SantangeloEzequiel/tdse-tf_3-06/images/Esquemático.pdf

256B

## DIR = 0x50

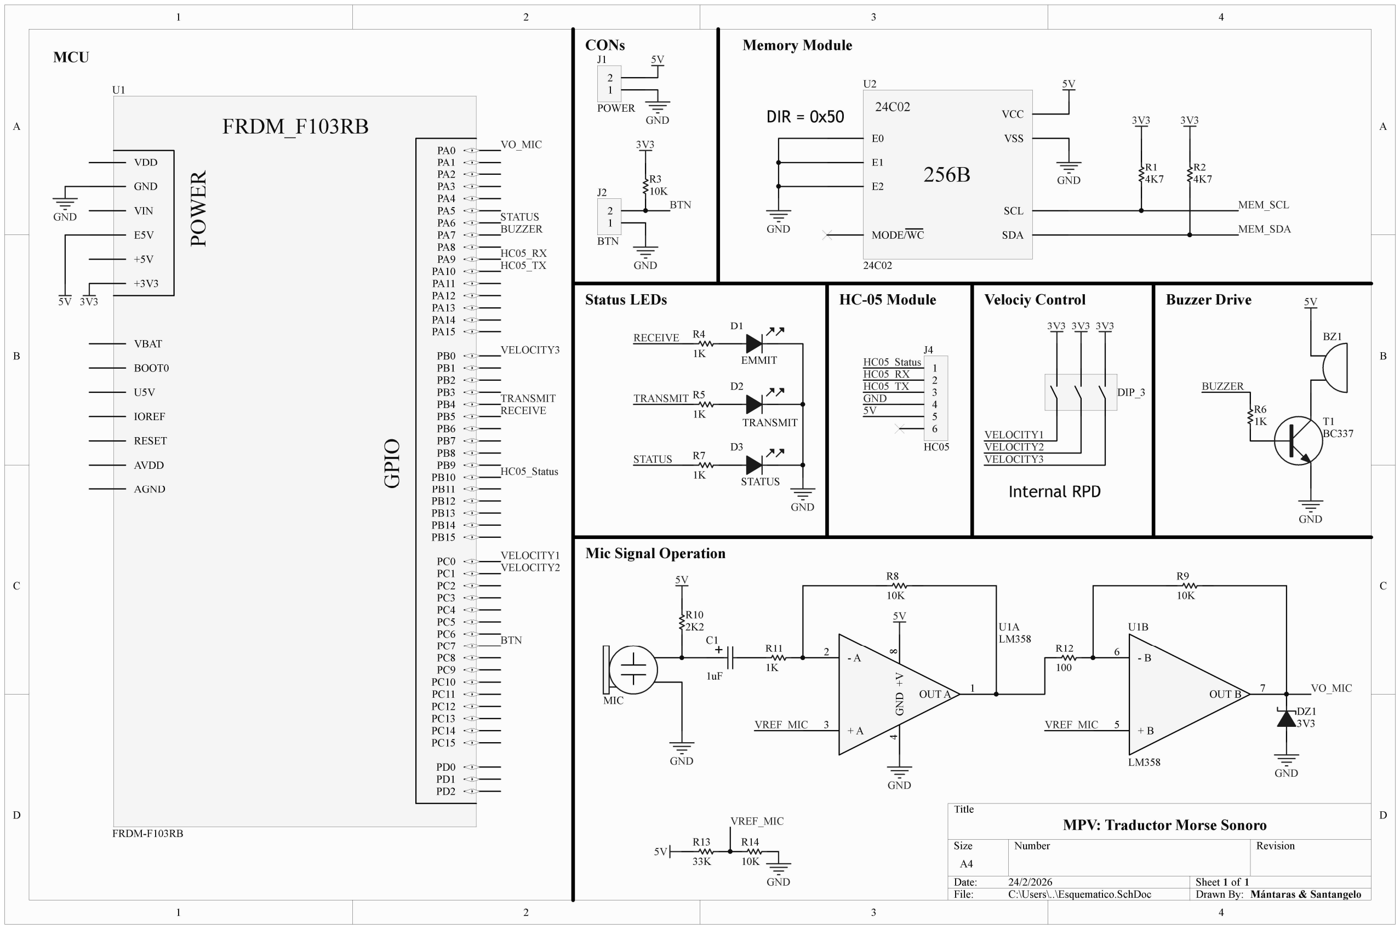
[picture p2: page 1]

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
Title

Size | Number | Revision
A4
Date: | 24/2/2026 | Sheet of
File: | C:\Users\..\Esquematico.SchDoc | Drawn By:

+ A 3

- A 2

OUT A 1 ⁺V

## 8 GND

4

U1A
LM358

24C02

E0

E1

E2

MODE/WC

VCC

VSS

SCL

SDA

U2

24C02

+ B 5

- B 6

OUT B 7

U1B

LM358

MIC

5V

GND

R1
4K7

R2
4K7

3V3 3V3

MEM_SCL

GND | MEM_SDA

T1
BC337

5V

GND

R6
1K

BUZZER

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
HC05 +

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
VO_MIC

VREF_MIC | VREF_MIC

5V

5V

R13
33K

R14
10K
GND

VREF_MIC

D2

TRANSMIT

D1

EMMIT

D3

STATUS

GND

R4
1K

R5
1K

R7
1K

RECEIVE

TRANSMIT

STATUS

HC05_Status
HC05_RX
HC05_TX
GND
5V

1

2

J1

POWER

GND

5V 3V3

DIP_3

3V3 3V3 3V3

VELOCITY1
VELOCITY2
VELOCITY3

# FRDM_F103RB

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
PA10
PA11
PA12
PA13
PA14
PA15

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
PB10
PB11
PB12
PB13
PB14
PB15

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
PC10
PC11
PC12
PC13
PC14
PC15

PA6

PC6

PB6 GPIO

PD0
PD1
PD2

PA0
VDD

GND

+3V3

+5V

VBAT

BOOT0

E5V

IOREF

RESET

VIN

AVDD

U5V

# AGND POWER

U1

FRDM-F103RB

GND

5V

VELOCITY1
VELOCITY2

VELOCITY3

HC05_Status

HC05_TX

HC05_RX

TRANSMIT
RECEIVE

STATUS

VO_MIC

## Internal RPD

BUZZER | 1
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
## MCU

CONs | Memory Module
Status LEDs | HC-05 Module | Velociy Control | Buzzer Drive

## Mic Signal Operation

## MPV: Traductor Morse Sonoro

1 1
Mántaras & Santangelo

BZ1
