SantangeloEzequiel/tdse-tf_3-06/images/Morse_Code.png

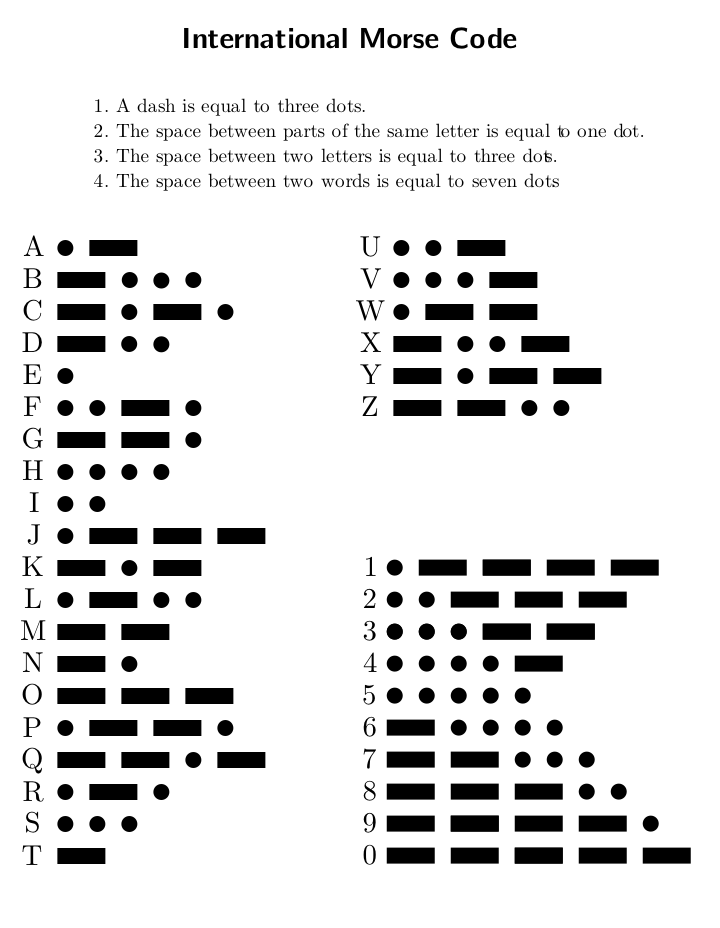
images/Morse_Code.png
