SantangeloEzequiel/tdse-tf_3-06/CubeIDEProjects/Grabador de Memoria/Core/Src/main.c

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
/* Includes ------------------------------------------------------------------*/
#include "main.h"
#include "i2c.h"
#include "usart.h"
#include "gpio.h"

/* USER CODE BEGIN Includes */
#include "morse.h"
#include <stdint.h>
/* USER CODE END Includes */

/* USER CODE BEGIN PD */
#define READ
#define WRITE
/* USER CODE END PD */


void SystemClock_Config(void);
/**
  * @brief  The application entry point.
  * @retval int
  */
int main(void)
{

  /* MCU Configuration--------------------------------------------------------*/

  /* Reset of all peripherals, Initializes the Flash interface and the Systick. */
  HAL_Init();

  /* Configure the system clock */
  SystemClock_Config();

  /* Initialize all configured peripherals */
  MX_GPIO_Init();
  MX_I2C1_Init();
  MX_USART2_UART_Init();
  /* Infinite loop */
  /* USER CODE BEGIN WHILE */
  while (1)
  {
    /* USER CODE END WHILE */

    /* USER CODE BEGIN 3 */
	#ifdef WRITE
	  for (uint8_t i = 0 ; i < MORSE_TOTAL_SPACE_BYTES/2 ; i+=2 ){
		  EEPROM_WriteByte( i, error.morse);
		  EEPROM_WriteByte( i+1, error.symbol);
	  };

	  for (uint8_t i = 0 ; i < MORSE_TOTAL_CHARACTERS ; i++ ){
		EEPROM_WriteByte( morse_table[i].index*2, morse_table[i].morse);
		EEPROM_WriteByte( morse_table[i].index*2 + 1, morse_table[i].symbol);
	  };
	  for (uint8_t i = 0 ; i < MORSE_TOTAL_CHARACTERS ; i++ ){
		EEPROM_WriteByte( morse_table_alphabet[i].index*2 + MORSE_TOTAL_SPACE_BYTES + 2, morse_table_alphabet[i].morse);
		EEPROM_WriteByte( morse_table_alphabet[i].index*2 + 1 + MORSE_TOTAL_SPACE_BYTES + 2, morse_table_alphabet[i].symbol);
	  };

	#endif
	#ifdef READ
	  uint8_t caracter , morse;
	  morse = EEPROM_ReadByte(0);
	  caracter = EEPROM_ReadByte(1);

	  morse = EEPROM_ReadByte(2);
	  caracter = EEPROM_ReadByte(3);

	  morse = EEPROM_ReadByte(4);
	  caracter = EEPROM_ReadByte(5);

	#endif
	  break;
  }
  /* USER CODE END 3 */
}

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
