SantangeloEzequiel/tdse-tf_3-06/CubeIDEProjects/Traductor Morse Sonoro/Traductor Morse Sonoro.ioc

Mcu.UserName=STM32F103RBTx
PA0-WKUP.GPIO_Label=MIC
PA0-WKUP.Signal=ADCx_IN0
PA1.Signal=S_TIM2_CH2
PA10.GPIO_Label=UART1_RX
PA10.Signal=USART1_RX
PA13.GPIO_Label=TMS
PA13.Signal=SYS_JTMS-SWDIO
PA14.GPIO_Label=TCK
PA14.Signal=SYS_JTCK-SWCLK
PA2.GPIO_Label=UART2_TX2
PA2.Signal=USART2_TX
PA3.GPIO_Label=UART2_RX
PA3.Signal=USART2_RX
PA6.GPIO_Label=LED_ERROR
PA6.Signal=GPIO_Output
PA7.GPIO_Label=BUZZER
PA7.Signal=GPIO_Output
PA9.GPIO_Label=UART1_TX
PA9.Signal=USART1_TX
PB0.GPIO_Label=VELOCITY3
PB0.Signal=GPIO_Input
PB10.GPIO_Label=UART1_STATUS
PB10.Signal=GPIO_Input
PB3.GPIO_Label=SWO
PB3.Signal=SYS_JTDO-TRACESWO
PB4.GPIO_Label=LED_TRANSMIT
PB4.Signal=GPIO_Output
PB5.GPIO_Label=LED_RECEIVE
PB5.Signal=GPIO_Output
PB6.Signal=I2C1_SCL
PB7.Signal=I2C1_SDA
PC0.GPIO_Label=VELOCITY1
PC0.Signal=GPIO_Input
PC1.GPIO_Label=VELOCITY2
PC1.Signal=GPIO_Input
PC13-TAMPER-RTC.GPIO_Label=B1 [Blue PushButton]
PC13-TAMPER-RTC.Signal=GPXTI13
PC14-OSC32_IN.Signal=RCC_OSC32_IN
PC15-OSC32_OUT.Signal=RCC_OSC32_OUT
PC7.GPIO_Label=BTN_INPUT
PC7.Signal=GPIO_Input
PD0-OSC_IN.Signal=RCC_OSC_IN
PD1-OSC_OUT.Signal=RCC_OSC_OUT
