SantangeloEzequiel/tdse-tf_3-06/CubeIDEProjects/Traductor Morse Sonoro/app/inc/task_sensor.h

#ifndef INC_TASK_SENSOR_H_
#define INC_TASK_SENSOR_H_

/********************** CPP guard ********************************************/
#ifdef __cplusplus
extern "C" {
#endif

/********************** inclusions *******************************************/

/********************** macros ***********************************************/

/********************** typedef **********************************************/

/********************** external data declaration ****************************/
extern uint32_t g_task_sensor_cnt;
extern volatile uint32_t g_task_sensor_tick_cnt;

/********************** external functions declaration ***********************/
extern void task_sensor_init(void *parameters);
extern void task_sensor_update(void *parameters);

/********************** End of CPP guard *************************************/
#ifdef __cplusplus
}
#endif

#endif /* TASK_INC_TASK_SENSOR_H_ */

/********************** end of file ******************************************/
