SantangeloEzequiel/tdse-tf_3-06/CubeIDEProjects/Traductor Morse Sonoro/app/src/task_GPIO_output.c

/********************** inclusions *******************************************/
/* Project includes */
#include "main.h"

/* Demo includes */
#include "logger.h"
#include "dwt.h"

/* Application & Tasks includes */
#include "board.h"
#include "app.h"
#include "task_GPIO_output_attribute.h"
#include "task_GPIO_output_interface.h"

/********************** macros and definitions *******************************/
#define G_TASK_ACT_CNT_INIT			0ul
#define G_TASK_ACT_TICK_CNT_INI		0ul

#define DEL_GPIO_XX_PUL				100ul
#define DEL_GPIO_XX_BLI				500ul
#define DEL_GPIO_XX_MIN				0ul

/********************** internal data declaration ****************************/
const task_GPIO_output_cfg_t task_GPIO_output_cfg_list[] = {
	{ID_LED_RECEIVE,  LED_RECEIVE_PORT,  LED_RECEIVE_PIN, LED_RECEIVE_ON,  LED_RECEIVE_OFF,
	 DEL_GPIO_XX_BLI, DEL_GPIO_XX_PUL},
	{ID_LED_TRANSMIT,  LED_TRANSMIT_PORT,  LED_TRANSMIT_PIN, LED_TRANSMIT_ON,  LED_TRANSMIT_OFF,
	 DEL_GPIO_XX_BLI, DEL_GPIO_XX_PUL},
	{ID_LED_ERROR,  LED_ERROR_PORT,  LED_ERROR_PIN, LED_ERROR_ON,  LED_ERROR_OFF,
		 DEL_GPIO_XX_BLI, DEL_GPIO_XX_PUL},
	{ID_BUZZER,  BUZZER_PORT,  BUZZER_PIN, BUZZER_ON,  BUZZER_OFF,
		DEL_GPIO_XX_BLI, DEL_GPIO_XX_PUL}
};

#define GPIO_OUTPUT_CFG_QTY	(sizeof(task_GPIO_output_cfg_list)/sizeof(task_GPIO_output_cfg_t))

task_GPIO_output_dta_t task_GPIO_output_dta_list[] = {
	{DEL_GPIO_XX_MIN, ST_GPIO_XX_BLINK_ON, EV_GPIO_XX_NOT_BLINK, false},
	{DEL_GPIO_XX_MIN, ST_GPIO_XX_BLINK_ON, EV_GPIO_XX_NOT_BLINK, false},
	{DEL_GPIO_XX_MIN, ST_GPIO_XX_OFF, EV_GPIO_XX_NOT_BLINK, false},
	{DEL_GPIO_XX_MIN, ST_GPIO_XX_OFF, EV_GPIO_XX_NOT_BLINK, false}
};

#define GPIO_OUTPUT_DTA_QTY	(sizeof(task_GPIO_output_dta_list)/sizeof(task_GPIO_output_dta_t))

/********************** internal functions declaration ***********************/
void task_GPIO_output_statechart(void);

/********************** internal data definition *****************************/
const char *p_task_GPIO_output 		= "Task Actuator (Actuator Statechart)";
const char *p_task_GPIO_output_ 		= "Non-Blocking & Update By Time Code";

/********************** external data declaration ****************************/
uint32_t g_task_GPIO_output_cnt;
volatile uint32_t g_task_GPIO_output_tick_cnt;

/********************** external functions definition ************************/
void task_GPIO_output_init(void *parameters)
{
	uint32_t index;
	const task_GPIO_output_cfg_t *p_task_GPIO_output_cfg;
	task_GPIO_output_dta_t *p_task_GPIO_output_dta;
	task_GPIO_output_st_t state;
	task_GPIO_output_ev_t event;
	bool b_event;

	/* Print out: Task Initialized */
	LOGGER_INFO(" ");
	LOGGER_INFO("  %s is running - %s", GET_NAME(task_GPIO_output_init), p_task_GPIO_output);
	LOGGER_INFO("  %s is a %s", GET_NAME(task_GPIO_output), p_task_GPIO_output_);

	/* Init & Print out: Task execution counter */
	g_task_GPIO_output_cnt = G_TASK_ACT_CNT_INIT;
	LOGGER_INFO("   %s = %lu", GET_NAME(g_task_GPIO_output_cnt), g_task_GPIO_output_cnt);

	for (index = 0; GPIO_OUTPUT_DTA_QTY > index; index++)
	{
		/* Update Task Actuator Configuration & Data Pointer */
		p_task_GPIO_output_cfg = &task_GPIO_output_cfg_list[index];
		p_task_GPIO_output_dta = &task_GPIO_output_dta_list[index];

		/* Init & Print out: Index & Task execution FSM */
		//state = ST_GPIO_XX_OFF;
		state = p_task_GPIO_output_dta->state;

		//event = EV_GPIO_XX_OFF;
		event = p_task_GPIO_output_dta->event;

		b_event = false;
		p_task_GPIO_output_dta->flag = b_event;

		LOGGER_INFO(" ");
		LOGGER_INFO("   %s = %lu   %s = %lu   %s = %lu   %s = %s",
					 GET_NAME(index), index,
					 GET_NAME(state), (uint32_t)state,
					 GET_NAME(event), (uint32_t)event,
					 GET_NAME(b_event), (b_event ? "true" : "false"));

		HAL_GPIO_WritePin(p_task_GPIO_output_cfg->gpio_port, p_task_GPIO_output_cfg->pin, p_task_GPIO_output_cfg->GPIO_off);
	}
}

void task_GPIO_output_update(void *parameters)
{
	bool b_time_update_required = false;

	/* Protect shared resource */
	__asm("CPSID i");	/* disable interrupts*/
    if (G_TASK_ACT_TICK_CNT_INI < g_task_GPIO_output_tick_cnt)
    {
		/* Update Tick Counter */
    	g_task_GPIO_output_tick_cnt--;
    	b_time_update_required = true;
    }
    __asm("CPSIE i");	/* enable interrupts */

    while (b_time_update_required)
    {
		/* Update Task Counter */
		g_task_GPIO_output_cnt++;

		/* Run Task Statechart */
    	task_GPIO_output_statechart();

    	/* Protect shared resource */
		__asm("CPSID i");	/* disable interrupts */
		if (G_TASK_ACT_TICK_CNT_INI < g_task_GPIO_output_tick_cnt)
		{
			/* Update Tick Counter */
			g_task_GPIO_output_tick_cnt--;
			b_time_update_required = true;
		}
		else
		{
			b_time_update_required = false;
		}
		__asm("CPSIE i");	/* enable interrupts */
    }
}

void task_GPIO_output_statechart(void)
{
	uint32_t index;
	const task_GPIO_output_cfg_t *p_task_GPIO_output_cfg;
	task_GPIO_output_dta_t *p_task_GPIO_output_dta;

	for (index = 0; GPIO_OUTPUT_DTA_QTY > index; index++)
	{
		/* Update Task Actuator Configuration & Data Pointer */
		p_task_GPIO_output_cfg = &task_GPIO_output_cfg_list[index];
		p_task_GPIO_output_dta = &task_GPIO_output_dta_list[index];

		switch (p_task_GPIO_output_dta->state)
		{
			case ST_GPIO_XX_OFF:

				if ((true == p_task_GPIO_output_dta->flag) && (EV_GPIO_XX_ON == p_task_GPIO_output_dta->event))
				{
					p_task_GPIO_output_dta->flag = false;
					HAL_GPIO_WritePin(p_task_GPIO_output_cfg->gpio_port, p_task_GPIO_output_cfg->pin, p_task_GPIO_output_cfg->GPIO_on);
					p_task_GPIO_output_dta->state = ST_GPIO_XX_ON;
				}

				if ((true == p_task_GPIO_output_dta->flag) && (EV_GPIO_XX_BLINK == p_task_GPIO_output_dta->event))
				{
					p_task_GPIO_output_dta->flag = false;
					p_task_GPIO_output_dta->tick = p_task_GPIO_output_cfg->tick_blink;
					HAL_GPIO_WritePin(p_task_GPIO_output_cfg->gpio_port, p_task_GPIO_output_cfg->pin, p_task_GPIO_output_cfg->GPIO_on);
					p_task_GPIO_output_dta->state = ST_GPIO_XX_BLINK_ON;
				}

				if ((true == p_task_GPIO_output_dta->flag) && (EV_GPIO_XX_PULSE == p_task_GPIO_output_dta->event))
				{
					p_task_GPIO_output_dta->flag = false;
					p_task_GPIO_output_dta->tick = p_task_GPIO_output_cfg->tick_pulse;
					HAL_GPIO_WritePin(p_task_GPIO_output_cfg->gpio_port, p_task_GPIO_output_cfg->pin, p_task_GPIO_output_cfg->GPIO_on);
					p_task_GPIO_output_dta->state = ST_GPIO_XX_PULSE;
				}

				break;

			case ST_GPIO_XX_ON:

				if ((true == p_task_GPIO_output_dta->flag) && (EV_GPIO_XX_OFF == p_task_GPIO_output_dta->event))
				{
					p_task_GPIO_output_dta->flag = false;
					HAL_GPIO_WritePin(p_task_GPIO_output_cfg->gpio_port, p_task_GPIO_output_cfg->pin, p_task_GPIO_output_cfg->GPIO_off);
					p_task_GPIO_output_dta->state = ST_GPIO_XX_OFF;
				}

				if ((true == p_task_GPIO_output_dta->flag) && (EV_GPIO_XX_BLINK == p_task_GPIO_output_dta->event))
				{
					p_task_GPIO_output_dta->flag = false;
					p_task_GPIO_output_dta->tick = p_task_GPIO_output_cfg->tick_blink;
					HAL_GPIO_WritePin(p_task_GPIO_output_cfg->gpio_port, p_task_GPIO_output_cfg->pin, p_task_GPIO_output_cfg->GPIO_on);
					p_task_GPIO_output_dta->state = ST_GPIO_XX_BLINK_ON;
				}

				break;

			case ST_GPIO_XX_BLINK_ON:

				if(p_task_GPIO_output_dta->tick > DEL_GPIO_XX_MIN){
					p_task_GPIO_output_dta->tick --;
				}else{
					p_task_GPIO_output_dta->tick = p_task_GPIO_output_cfg->tick_blink;
					HAL_GPIO_WritePin(p_task_GPIO_output_cfg->gpio_port, p_task_GPIO_output_cfg->pin, p_task_GPIO_output_cfg->GPIO_off);
					p_task_GPIO_output_dta->state = ST_GPIO_XX_BLINK_OFF;
				}

				if ((true == p_task_GPIO_output_dta->flag) && (EV_GPIO_XX_ON == p_task_GPIO_output_dta->event))
				{
					p_task_GPIO_output_dta->flag = false;
					p_task_GPIO_output_dta->tick = DEL_GPIO_XX_MIN;
					HAL_GPIO_WritePin(p_task_GPIO_output_cfg->gpio_port, p_task_GPIO_output_cfg->pin, p_task_GPIO_output_cfg->GPIO_on);
					p_task_GPIO_output_dta->state = ST_GPIO_XX_ON;
				}
				if ((true == p_task_GPIO_output_dta->flag) && (EV_GPIO_XX_OFF == p_task_GPIO_output_dta->event))
				{
					p_task_GPIO_output_dta->flag = false;
					p_task_GPIO_output_dta->tick = DEL_GPIO_XX_MIN;
					HAL_GPIO_WritePin(p_task_GPIO_output_cfg->gpio_port, p_task_GPIO_output_cfg->pin, p_task_GPIO_output_cfg->GPIO_off);
					p_task_GPIO_output_dta->state = ST_GPIO_XX_OFF;
				}

				break;


			case ST_GPIO_XX_BLINK_OFF:

				if(p_task_GPIO_output_dta->tick > DEL_GPIO_XX_MIN){
					p_task_GPIO_output_dta->tick --;
				}else{
					p_task_GPIO_output_dta->tick = p_task_GPIO_output_cfg->tick_blink;
					HAL_GPIO_WritePin(p_task_GPIO_output_cfg->gpio_port, p_task_GPIO_output_cfg->pin, p_task_GPIO_output_cfg->GPIO_on);
					p_task_GPIO_output_dta->state = ST_GPIO_XX_BLINK_ON;
				}

				if ((true == p_task_GPIO_output_dta->flag) && (EV_GPIO_XX_ON == p_task_GPIO_output_dta->event))
				{
					p_task_GPIO_output_dta->flag = false;
					p_task_GPIO_output_dta->tick = DEL_GPIO_XX_MIN;
					HAL_GPIO_WritePin(p_task_GPIO_output_cfg->gpio_port, p_task_GPIO_output_cfg->pin, p_task_GPIO_output_cfg->GPIO_on);
					p_task_GPIO_output_dta->state = ST_GPIO_XX_ON;
				}
				if ((true == p_task_GPIO_output_dta->flag) && (EV_GPIO_XX_OFF == p_task_GPIO_output_dta->event))
				{
					p_task_GPIO_output_dta->flag = false;
					p_task_GPIO_output_dta->tick = DEL_GPIO_XX_MIN;
					HAL_GPIO_WritePin(p_task_GPIO_output_cfg->gpio_port, p_task_GPIO_output_cfg->pin, p_task_GPIO_output_cfg->GPIO_off);
					p_task_GPIO_output_dta->state = ST_GPIO_XX_OFF;
				}

				break;

			case ST_GPIO_XX_PULSE:

				if(p_task_GPIO_output_dta->tick > DEL_GPIO_XX_MIN){
					p_task_GPIO_output_dta->tick --;
				}else
				{
					HAL_GPIO_WritePin(p_task_GPIO_output_cfg->gpio_port, p_task_GPIO_output_cfg->pin, p_task_GPIO_output_cfg->GPIO_off);
					p_task_GPIO_output_dta->state = ST_GPIO_XX_OFF;
				}

				break;

			default:

				p_task_GPIO_output_dta->tick  = DEL_GPIO_XX_MIN;
				p_task_GPIO_output_dta->state = ST_GPIO_XX_OFF;
				p_task_GPIO_output_dta->event = EV_GPIO_XX_OFF;
				p_task_GPIO_output_dta->flag = false;

				break;
		}
	}
}

/********************** end of file ******************************************/
