SantangeloEzequiel/tdse-tf_3-06/CubeIDEProjects/Traductor Morse Sonoro/app/src/task_system.c

/********************** inclusions *******************************************/
/* Project includes */
#include "main.h"

/* Demo includes */
#include "logger.h"
#include "dwt.h"

/* Application & Tasks includes */
#include "board.h"
#include "app.h"
#include "task_HC05_interface.h"
#include "task_system_attribute.h"
#include "task_system_interface.h"
#include "task_GPIO_output_attribute.h"
#include "task_GPIO_output_interface.h"
#include "memoria_morse.h"

/********************** macros and definitions *******************************/
#define G_TASK_SYS_CNT_INI			0ul
#define G_TASK_SYS_TICK_CNT_INI		0ul

#define DEL_SYS_MIN					0ul
#define DEL_SYS_MED					50ul
#define DEL_SYS_MAX					500ul

#define WORDS_PER_MINUTE			240 //ms
#define MORSE_SPACE					7	//dots
#define MORSE_SPACE_CHAR			3	//dots
#define MORSE_SPACE_MORSE			1	//dots

#define DOT_LEN						1
#define LINE_LEN					3

#define LOW_SIGNAL					0
#define HIGH_SIGNAL					1
#define LOW_SIGNAL_SYMBOL			'0'
#define HIGH_SIGNAL_SYMBOL			'1'
#define ON_BOARD_DECODE 			false
#define MAIN_SIGNAL_PERIOD			5

#define VELOCITY1					70
#define VELOCITY2					70
#define VELOCITY3					70

#define RECEIVE_CODE				'.'
#define TRANSMIT_CODE				'#'

#define NULL_MESSAGE				'\0'

#define RX_UNIT_TICKS_INIT			120ul
#define RX_UNIT_TICKS_MIN			10ul
#define RX_UNIT_TICKS_MAX			400ul
#define RX_DOT_LINE_FACTOR			2ul
#define RX_CHAR_GAP_FACTOR			3ul
#define RX_WORD_GAP_FACTOR			7ul



/********************** internal data declaration ****************************/
task_system_dta_t task_system_dta =
	{DEL_SYS_MIN, ST_SYS_RECEIVING, ST_SYS_WAITING_CONNECTION, {0} , 0 , WORDS_PER_MINUTE ,
	 G_TASK_SYS_CNT_INI , false , false , LOW_SIGNAL , LOW_SIGNAL , LOW_SIGNAL,
	 {0}, 0u, {0}, 0u , 0u , RX_UNIT_TICKS_INIT, LOW_SIGNAL, false, false, MORSE_STARTING_INDEX, 0u};

#define SYSTEM_DTA_QTY	(sizeof(task_system_dta)/sizeof(task_system_dta_t))

/********************** internal functions declaration ***********************/
void task_system_statechart(void);
void velocity_management(task_system_dta_t*);
static void rx_decoder_reset(task_system_dta_t *p_task_system_dta);
static void rx_decoder_commit_symbol(task_system_dta_t *p_task_system_dta, bool add_word_space);
static void rx_decoder_register_mark(task_system_dta_t *p_task_system_dta, uint32_t mark_ticks);
static void rx_decoder_update(task_system_dta_t *p_task_system_dta, bool input_signal);

/********************** internal data definition *****************************/
const char *p_task_system 		= "Task System (System Statechart)";
const char *p_task_system_ 		= "Non-Blocking & Update By Time Code";

/********************** external data declaration ****************************/
uint32_t g_task_system_cnt;
volatile uint32_t g_task_system_tick_cnt;

/********************** external functions definition ************************/
void task_system_init(void *parameters)
{
	task_system_dta_t 	*p_task_system_dta;
	task_system_st_t	state;
	task_system_ev_t	event;
	bool b_event;

	/* Print out: Task Initialized */
	LOGGER_INFO(" ");
	LOGGER_INFO("  %s is running - %s", GET_NAME(task_system_init), p_task_system);
	LOGGER_INFO("  %s is a %s", GET_NAME(task_system), p_task_system_);

	/* Init & Print out: Task execution counter */
	g_task_system_cnt = G_TASK_SYS_CNT_INI;
	LOGGER_INFO("   %s = %lu", GET_NAME(g_task_system_cnt), g_task_system_cnt);

	init_queue_event_task_system();

	/* Update Task Actuator Configuration & Data Pointer */
	p_task_system_dta = &task_system_dta;
	rx_decoder_reset(p_task_system_dta);

	/* Init & Print out: Task execution FSM */
	state = ST_SYS_WAITING_CONNECTION;
	p_task_system_dta->state = state;

	event = EV_SYS_CONNECTION_LOST;
	p_task_system_dta->event = event;

	b_event = false;
	p_task_system_dta->flag = b_event;


	LOGGER_INFO(" ");
	LOGGER_INFO("   %s = %lu   %s = %lu   %s = %s",
				 GET_NAME(state), (uint32_t)state,
				 GET_NAME(event), (uint32_t)event,
				 GET_NAME(b_event), (b_event ? "true" : "false"));
}

void task_system_update(void *parameters)
{
	bool b_time_update_required = false;

	/* Protect shared resource */
	__asm("CPSID i");	/* disable interrupts */
    if (G_TASK_SYS_TICK_CNT_INI < g_task_system_tick_cnt)
    {
		/* Update Tick Counter */
    	g_task_system_tick_cnt--;
    	b_time_update_required = true;
    }
    __asm("CPSIE i");	/* enable interrupts */

    while (b_time_update_required)
    {
		/* Update Task Counter */
		g_task_system_cnt++;

		/* Run Task Statechart */
    	task_system_statechart();

    	/* Protect shared resource */
		__asm("CPSID i");	/* disable interrupts */
		if (G_TASK_SYS_TICK_CNT_INI < g_task_system_tick_cnt)
		{
			/* Update Tick Counter */
			g_task_system_tick_cnt--;
			b_time_update_required = true;
		}
		else
		{
			b_time_update_required = false;
		}
		__asm("CPSIE i");	/* enable interrupts */
    }
}

void task_system_statechart(void)
{
	task_system_dta_t *p_task_system_dta;
	char message = NULL_MESSAGE;

	/* Update Task System Data Pointer */
	p_task_system_dta = &task_system_dta;

	if (true == any_event_task_system())
	{
		p_task_system_dta->flag = true;
		p_task_system_dta->event = get_event_task_system();
	}

	switch (p_task_system_dta->state)
	{
		case ST_SYS_WAITING_CONNECTION:

			if(p_task_system_dta->flag == true && p_task_system_dta->event == EV_SYS_CONNECTION_ESTABLISHED){
				p_task_system_dta->state = ST_SYS_RECEIVING;
				rx_decoder_reset(p_task_system_dta);
				put_event_task_GPIO_output(EV_GPIO_XX_ON, ID_LED_RECEIVE);
				put_event_task_GPIO_output(EV_GPIO_XX_OFF, ID_LED_TRANSMIT);
			}

			if(p_task_system_dta->flag) {velocity_management(p_task_system_dta);}
			p_task_system_dta->flag = false;
			break;

		case ST_SYS_RECEIVING:
			// RX command channel from peer
		    if(any_message_task_system()){
		        message = get_message_task_system();
		    }

		    // MIC events
		    if(p_task_system_dta->flag && p_task_system_dta->event == EV_SYS_MIC_INPUT_ON){
		        put_event_task_GPIO_output(EV_GPIO_XX_ON, ID_LED_ERROR);
		        p_task_system_dta->input_mic = HIGH_SIGNAL;

		    }else if(p_task_system_dta->flag && p_task_system_dta->event == EV_SYS_MIC_INPUT_OFF){
		        put_event_task_GPIO_output(EV_GPIO_XX_OFF, ID_LED_ERROR);
		        p_task_system_dta->input_mic = LOW_SIGNAL;
		    }

		    // BTN events
		    if(p_task_system_dta->flag && p_task_system_dta->event == EV_SYS_BTN_INPUT_OFF){
		        put_event_task_GPIO_output(EV_GPIO_XX_ON, ID_BUZZER);
		        p_task_system_dta->input_btn = HIGH_SIGNAL;

		    }else if(p_task_system_dta->flag && p_task_system_dta->event == EV_SYS_BTN_INPUT_ON){
		        put_event_task_GPIO_output(EV_GPIO_XX_OFF, ID_BUZZER);
		        p_task_system_dta->input_btn = LOW_SIGNAL;
		    }

		    // Compute logical input from mic OR button
		    uint8_t new_state =
		        (p_task_system_dta->input_mic == HIGH_SIGNAL ||
		         p_task_system_dta->input_btn == HIGH_SIGNAL)
		        ? HIGH_SIGNAL
		        : LOW_SIGNAL;

		    /* Transmit only if state changed */
		    if (ON_BOARD_DECODE)
		    {
		        p_task_system_dta->input_signal = new_state;
		        rx_decoder_update(p_task_system_dta,
		                          p_task_system_dta->input_signal);
		    }
		    else
		    {
		        if (new_state != p_task_system_dta->input_signal)
		        {
		            p_task_system_dta->input_signal = new_state;

		            if (new_state == HIGH_SIGNAL)
		                put_tx_message_task_HC05(HIGH_SIGNAL_SYMBOL);
		            else
		                put_tx_message_task_HC05(LOW_SIGNAL_SYMBOL);
		        }
		    }


			if(message == TRANSMIT_CODE){
				rx_decoder_commit_symbol(p_task_system_dta, false);
				p_task_system_dta->state = ST_SYS_TRANSMITTING;
				p_task_system_dta->tick = DEL_SYS_MIN;
				put_event_task_GPIO_output(EV_GPIO_XX_OFF, ID_LED_RECEIVE);
				put_event_task_GPIO_output(EV_GPIO_XX_ON, ID_LED_TRANSMIT);
				put_event_task_GPIO_output(EV_GPIO_XX_OFF, ID_LED_ERROR);
				put_event_task_GPIO_output(EV_GPIO_XX_OFF, ID_BUZZER);
			}
			//RECEIVING SEQUENCE

			if(p_task_system_dta->flag == true && p_task_system_dta->event == EV_SYS_CONNECTION_LOST){
				rx_decoder_reset(p_task_system_dta);
				p_task_system_dta->state = ST_SYS_WAITING_CONNECTION;
				p_task_system_dta->tick = DEL_SYS_MIN;
				put_event_task_GPIO_output(EV_GPIO_XX_BLINK, ID_LED_RECEIVE);
				put_event_task_GPIO_output(EV_GPIO_XX_BLINK, ID_LED_TRANSMIT);
				put_event_task_GPIO_output(EV_GPIO_XX_OFF, ID_LED_ERROR);
				put_event_task_GPIO_output(EV_GPIO_XX_OFF, ID_BUZZER);
			}

			if(p_task_system_dta->flag) {velocity_management(p_task_system_dta);}
			p_task_system_dta->flag = false;
			break;


		case ST_SYS_TRANSMITTING:

			//TRANSMITTING SEQUENCE
			if(any_message_task_system()){

				message = get_message_task_system();
				if(message == RECEIVE_CODE){
					rx_decoder_reset(p_task_system_dta);
					p_task_system_dta->state = ST_SYS_RECEIVING;
					put_event_task_GPIO_output(EV_GPIO_XX_ON, ID_LED_RECEIVE);
					put_event_task_GPIO_output(EV_GPIO_XX_OFF, ID_LED_TRANSMIT);
					put_event_task_GPIO_output(EV_GPIO_XX_OFF, ID_LED_ERROR);
					put_event_task_GPIO_output(EV_GPIO_XX_OFF, ID_BUZZER);
				} else {
 					EEPROM_SymbolToMorse(&p_task_system_dta->morse_character, message);
					if(p_task_system_dta->morse_character.ascii_symbol != morse_error.ascii_symbol){
						p_task_system_dta->morse_character_tick = 0;
						p_task_system_dta->state = ST_SYS_TRANSMITTING_CHAR;
					}else {
						put_event_task_GPIO_output(EV_GPIO_XX_PULSE, ID_LED_ERROR);
					}
				}
			}
			//TRANSMITTING SEQUENCE

			if(p_task_system_dta->flag == true && p_task_system_dta->event == EV_SYS_CONNECTION_LOST){
				p_task_system_dta->state = ST_SYS_WAITING_CONNECTION;
				put_event_task_GPIO_output(EV_GPIO_XX_BLINK, ID_LED_RECEIVE);
				put_event_task_GPIO_output(EV_GPIO_XX_BLINK, ID_LED_TRANSMIT);
				put_event_task_GPIO_output(EV_GPIO_XX_OFF, ID_LED_ERROR);
				put_event_task_GPIO_output(EV_GPIO_XX_OFF, ID_BUZZER);
			}

			p_task_system_dta->WPM_flag = false;

			if(p_task_system_dta->flag) {velocity_management(p_task_system_dta);}
			p_task_system_dta->flag = false;

			break;
		case ST_SYS_TRANSMITTING_CHAR:

			p_task_system_dta->WPM_tick++;
			if(p_task_system_dta->WPM_tick >= p_task_system_dta->WPM_period){
				p_task_system_dta->WPM_flag = true;
				p_task_system_dta->WPM_tick = 0;
			}

			if(p_task_system_dta->WPM_flag){
				if(p_task_system_dta->morse_character_tick %2 && p_task_system_dta->morse_character.len*2 - 1 >  p_task_system_dta->morse_character_tick){

					p_task_system_dta->state = ST_SYS_TRANSMITTING_WAIT;
					p_task_system_dta->tick = MORSE_SPACE_MORSE;
					p_task_system_dta->morse_character_tick++;

				} else if(p_task_system_dta->morse_character.len*2 - 1 >  p_task_system_dta->morse_character_tick){


					if(p_task_system_dta->morse_character.morse_sequence[p_task_system_dta->morse_character_tick/2] == DOT){
						put_event_task_GPIO_output(EV_GPIO_XX_ON , ID_BUZZER);
						p_task_system_dta->state = ST_SYS_TRANSMITTING_WAIT;
						p_task_system_dta->tick = DOT_LEN;
					}else if (p_task_system_dta->morse_character.morse_sequence[p_task_system_dta->morse_character_tick/2] == LINE){
						put_event_task_GPIO_output(EV_GPIO_XX_ON , ID_BUZZER);
						p_task_system_dta->state = ST_SYS_TRANSMITTING_WAIT;
						p_task_system_dta->tick = LINE_LEN;
					} else { //Caso espacio
						put_event_task_GPIO_output(EV_GPIO_XX_OFF , ID_BUZZER);
						p_task_system_dta->state = ST_SYS_TRANSMITTING_WAIT;
						p_task_system_dta->tick = MORSE_SPACE - 1;
					}
					p_task_system_dta->morse_character_tick++;
				}else if (p_task_system_dta->morse_character.len*2 - 1 ==  p_task_system_dta->morse_character_tick){
					p_task_system_dta->state = ST_SYS_TRANSMITTING_WAIT;
					p_task_system_dta->tick = MORSE_SPACE_MORSE;
					p_task_system_dta->morse_character_tick ++;
				} else {
					p_task_system_dta->state = ST_SYS_TRANSMITTING;
					p_task_system_dta->tick = 0;
					p_task_system_dta->morse_character_tick = 0;
				}
				p_task_system_dta->WPM_flag = false;
			}

			if(p_task_system_dta->flag) {velocity_management(p_task_system_dta);}
			p_task_system_dta->flag = false;
			break;

		case ST_SYS_TRANSMITTING_WAIT:
			p_task_system_dta->WPM_tick++;
			if(p_task_system_dta->WPM_tick >= p_task_system_dta->WPM_period){
				p_task_system_dta->WPM_flag = true;
				p_task_system_dta->WPM_tick = 0;
			}

			if(p_task_system_dta->WPM_flag){
				p_task_system_dta->tick--;
				p_task_system_dta->WPM_flag = false;
			}
			if(p_task_system_dta->tick == 0){
				put_event_task_GPIO_output(EV_GPIO_XX_OFF , ID_BUZZER);
				p_task_system_dta->state = ST_SYS_TRANSMITTING_CHAR;
			}

			if(p_task_system_dta->flag) {velocity_management(p_task_system_dta);}
			p_task_system_dta->flag = false;
			break;
		default:
			break;
	}
}

void velocity_management(task_system_dta_t* p_task_system_dta){
	switch(p_task_system_dta->event){
		case EV_SYS_VELOCITY1_ON:
			p_task_system_dta->WPM_period += VELOCITY1;
			break;
		case EV_SYS_VELOCITY1_OFF:
			p_task_system_dta->WPM_period -= VELOCITY1;
			break;
		case EV_SYS_VELOCITY2_ON:
			p_task_system_dta->WPM_period += VELOCITY2;
			break;
		case EV_SYS_VELOCITY2_OFF:
			p_task_system_dta->WPM_period -= VELOCITY2;
			break;
		case EV_SYS_VELOCITY3_ON:
			p_task_system_dta->WPM_period += VELOCITY3;
			break;
		case EV_SYS_VELOCITY3_OFF:
			p_task_system_dta->WPM_period -= VELOCITY3;
			break;
		default:
			break;
	}
}

static void rx_decoder_reset(task_system_dta_t* p_task_system_dta)
{
	p_task_system_dta->rx_current_symbol = starting_symbol;
	p_task_system_dta->rx_high_ticks = 0;
	p_task_system_dta->rx_low_ticks = 0;
	p_task_system_dta->rx_unit_ticks = RX_UNIT_TICKS_INIT;
	p_task_system_dta->rx_prev_signal = LOW_SIGNAL;
	p_task_system_dta->rx_symbol_started = false;
	p_task_system_dta->rx_char_committed = false;
	p_task_system_dta->rx_symbol_index = MORSE_STARTING_INDEX;
	p_task_system_dta->rx_symbol_len = 0;
}

static void rx_decoder_commit_symbol(task_system_dta_t* p_task_system_dta, bool add_word_space)
{
	if (p_task_system_dta->rx_symbol_started)
	{
		if ((p_task_system_dta->rx_symbol_len >= MIN_MORSE_LEN) && (p_task_system_dta->rx_symbol_len <= MAX_MORSE_LEN) && (p_task_system_dta->rx_symbol_index <= MORSE_MAX_INDEX))
		{
			/* Keep it simple: decode once when a gap commits the symbol. */
			EEPROM_ReadSymbol(&p_task_system_dta->rx_current_symbol, p_task_system_dta->rx_symbol_index);
			if ((p_task_system_dta->rx_current_symbol.ascii_symbol != morse_error.ascii_symbol) &&
				(p_task_system_dta->rx_current_symbol.ascii_symbol != starting_symbol.ascii_symbol))
			{
				put_tx_message_task_HC05(p_task_system_dta->rx_current_symbol.ascii_symbol);
			}
		}
	}

	if (add_word_space)
	{
		put_tx_message_task_HC05(' ');
		p_task_system_dta->rx_char_committed = false;
	}

	p_task_system_dta->rx_current_symbol = starting_symbol;
	p_task_system_dta->rx_symbol_started = false;
	p_task_system_dta->rx_symbol_index = MORSE_STARTING_INDEX;
	p_task_system_dta->rx_symbol_len = 0;
}

static void rx_decoder_register_mark(task_system_dta_t *p_task_system_dta, uint32_t mark_ticks)
{
	morse_input symbol;
	uint32_t estimate;

	if (mark_ticks == 0)
	{
		return;
	}

	if (p_task_system_dta->rx_unit_ticks < RX_UNIT_TICKS_MIN)
	{
		p_task_system_dta->rx_unit_ticks = RX_UNIT_TICKS_MIN;
	}

	symbol = (mark_ticks <= (p_task_system_dta->rx_unit_ticks * RX_DOT_LINE_FACTOR)) ? DOT : LINE;

	if (p_task_system_dta->rx_symbol_len < MAX_MORSE_LEN)
	{
		p_task_system_dta->rx_symbol_index = EEPROM_NextSymbol(p_task_system_dta->rx_symbol_index, symbol);
		p_task_system_dta->rx_symbol_len++;
	}
	else
	{
		/* Mark as invalid; commit will report error once. */
		p_task_system_dta->rx_symbol_index = (uint8_t)(MORSE_MAX_INDEX + 2u);
	}
	p_task_system_dta->rx_symbol_started = true;

	estimate = (symbol == DOT) ? mark_ticks : (mark_ticks / 3u);
	if (estimate < RX_UNIT_TICKS_MIN)
	{
		estimate = RX_UNIT_TICKS_MIN;
	}
	else if (estimate > RX_UNIT_TICKS_MAX)
	{
		estimate = RX_UNIT_TICKS_MAX;
	}


	p_task_system_dta->rx_unit_ticks = ((p_task_system_dta->rx_unit_ticks * 3u) + estimate) / 4u;
}

static void rx_decoder_update(task_system_dta_t* p_task_system_dta, bool input_signal)
{
	if (input_signal == HIGH_SIGNAL)
	{
		p_task_system_dta->rx_high_ticks++;

		if (p_task_system_dta->rx_prev_signal == LOW_SIGNAL)
		{
			if (p_task_system_dta->rx_char_committed &&
			    (p_task_system_dta->rx_low_ticks < (p_task_system_dta->rx_unit_ticks * RX_WORD_GAP_FACTOR)))
			{
				/* New mark before word gap: next symbol belongs to same word. */
				p_task_system_dta->rx_char_committed = false;
			}

			if (p_task_system_dta->rx_symbol_started)
			{
				if (p_task_system_dta->rx_low_ticks >= (p_task_system_dta->rx_unit_ticks * RX_WORD_GAP_FACTOR))
				{
					rx_decoder_commit_symbol(p_task_system_dta, true);
				}
				else if (p_task_system_dta->rx_low_ticks >= (p_task_system_dta->rx_unit_ticks * RX_CHAR_GAP_FACTOR))
				{
					rx_decoder_commit_symbol(p_task_system_dta, false);
					p_task_system_dta->rx_char_committed = true;
				}
				else
				{
					uint32_t gap_estimate = p_task_system_dta->rx_low_ticks;
					if ((gap_estimate >= RX_UNIT_TICKS_MIN) && (gap_estimate <= RX_UNIT_TICKS_MAX))
					{
						p_task_system_dta->rx_unit_ticks = ((p_task_system_dta->rx_unit_ticks * 3u) + gap_estimate) / 4u;
					}
				}
			}
			p_task_system_dta->rx_low_ticks = 0;
		}
	}
	else
	{
		p_task_system_dta->rx_low_ticks++;

		if (p_task_system_dta->rx_prev_signal == HIGH_SIGNAL)
		{
			rx_decoder_register_mark(p_task_system_dta, p_task_system_dta->rx_high_ticks);
			p_task_system_dta->rx_high_ticks = 0;
		}

		/* Flush character as soon as char-gap is reached, even without next mark. */
		if (p_task_system_dta->rx_symbol_started &&
		    (p_task_system_dta->rx_low_ticks >= (p_task_system_dta->rx_unit_ticks * RX_CHAR_GAP_FACTOR)))
		{
			rx_decoder_commit_symbol(p_task_system_dta, false);
			p_task_system_dta->rx_char_committed = true;
		}

		if (p_task_system_dta->rx_symbol_started && (p_task_system_dta->rx_low_ticks >= (p_task_system_dta->rx_unit_ticks * RX_WORD_GAP_FACTOR)))
		{
			rx_decoder_commit_symbol(p_task_system_dta, true);
			p_task_system_dta->rx_low_ticks = 0;
		}

		if (p_task_system_dta->rx_char_committed &&
		    (p_task_system_dta->rx_low_ticks >= (p_task_system_dta->rx_unit_ticks * RX_WORD_GAP_FACTOR)))
		{
			put_tx_message_task_HC05(' ');
			p_task_system_dta->rx_char_committed = false;
			p_task_system_dta->rx_low_ticks = 0;
		}
	}

	p_task_system_dta->rx_prev_signal = input_signal;
}
/********************** end of file ******************************************/
