SantangeloEzequiel/tdse-tf_3-06/CubeIDEProjects/Traductor Morse Sonoro/app/inc/task_GPIO_output_interface.h

#ifndef INC_TASK_GPIO_OUTPUT_INTERFACE_H_
#define INC_TASK_GPIO_OUTPUT_INTERFACE_H_

/********************** CPP guard ********************************************/
#ifdef __cplusplus
extern "C" {
#endif

/********************** inclusions *******************************************/

/********************** macros ***********************************************/

/********************** typedef **********************************************/

/********************** external data declaration ****************************/

/********************** external functions declaration ***********************/
extern void put_event_task_GPIO_output(task_GPIO_output_ev_t event, task_GPIO_output_id_t identifier);

/********************** End of CPP guard *************************************/
#ifdef __cplusplus
}
#endif

#endif /* TASK_INC_TASK_GPIO_OUTPUT_INTERFACE_H_ */

/********************** end of file ******************************************/
