SantangeloEzequiel/tdse-tf_3-06/(commit log)

2025-11-11 casos de uso en Readme
2026-02-01 Módulos Funcionales
    Aplicación funcional de módulos:
    Bluetooth (HC-05)
    Micrófono (Detección de frecuencias 3-5kHz para zumbador)
    Memoria (Organización de código morse en formato de árbol de búsqueda binaria)
    [Grabador de Memoria.cfg, Traductor Morse Sonoro Debug.cfg]
2026-02-09 Actualizaciones
    Implementadas funciones para unificación:
    - Lectura de memoria
    -Definición de pines y cantidad de botones
    - Primera implementación de task_system.
2026-02-16 Transmisión Operativa
    Implementación de algoritmo de transmisión. Recibe caracteres, emite morse.
    [Grabador de Memoria.cfg, Traductor Morse Sonoro Debug.cfg]
2026-03-04 Primera versión operativa de firmware
    Proyecto operativo.
    Movida carpeta del proyecto.
    [Traductor Morse Sonoro Debug.cfg]
2026-03-05 Correcciones sobre V1
    Corregidas todas las warnings
    Mejorado sistema de transferencia de señal morse
    Movida carpeta del proyecto Grabador de Memoria
    [Grabador de Memoria.cfg]
2026-03-09 Actualización de Informe_Final.md
    Agregados componentes y requisitos del proyecto
2026-03-14 Agregados Statecharts y descripción de firmware.
2026-03-15 Agrego Diagrama de Harel de la app a las imagenes
2026-03-15 Actualizar Informe_Final.md con detalles de detección de Morse
    Se actualizó el contenido del informe para incluir detalles sobre la lógica de detección de Morse y su implementación en el proyecto, así como enlaces a repositorios y aplicaciones relacionadas.
2026-03-18 Agregadas imagenes de osc
2026-03-20 Agregadas imágenes de consola
2026-03-20 Agregado esquema eléctrico de entrada y ajustado WCET para nueva optimización.
2026-03-20 Agregado banco de trabajo
2026-04-14 Actualizado y mejorado algoritmo de detección
2026-10-04 Actualización de informe con video demostrativo
2026-10-09 introduccion a las figuras antes de mostrarlas
2026-10-09 Agregado Introducción general como piden las pautas
    Added sections for prototype comparison and scope.
2026-11-08 Update Informe_Final.md
    Correcciones para presentación.
